JulianKang/ece477/(list of files, cad)

Other CAD files:
Assembly v8.f3d
