JulianKang/ece477/0_assemb_ledboard/blinkyboard/blinkyboard.kicad_pcb

## KiCad design 0_assemb_ledboard/blinkyboard/blinkyboard.kicad_pcb (2024-03-07)

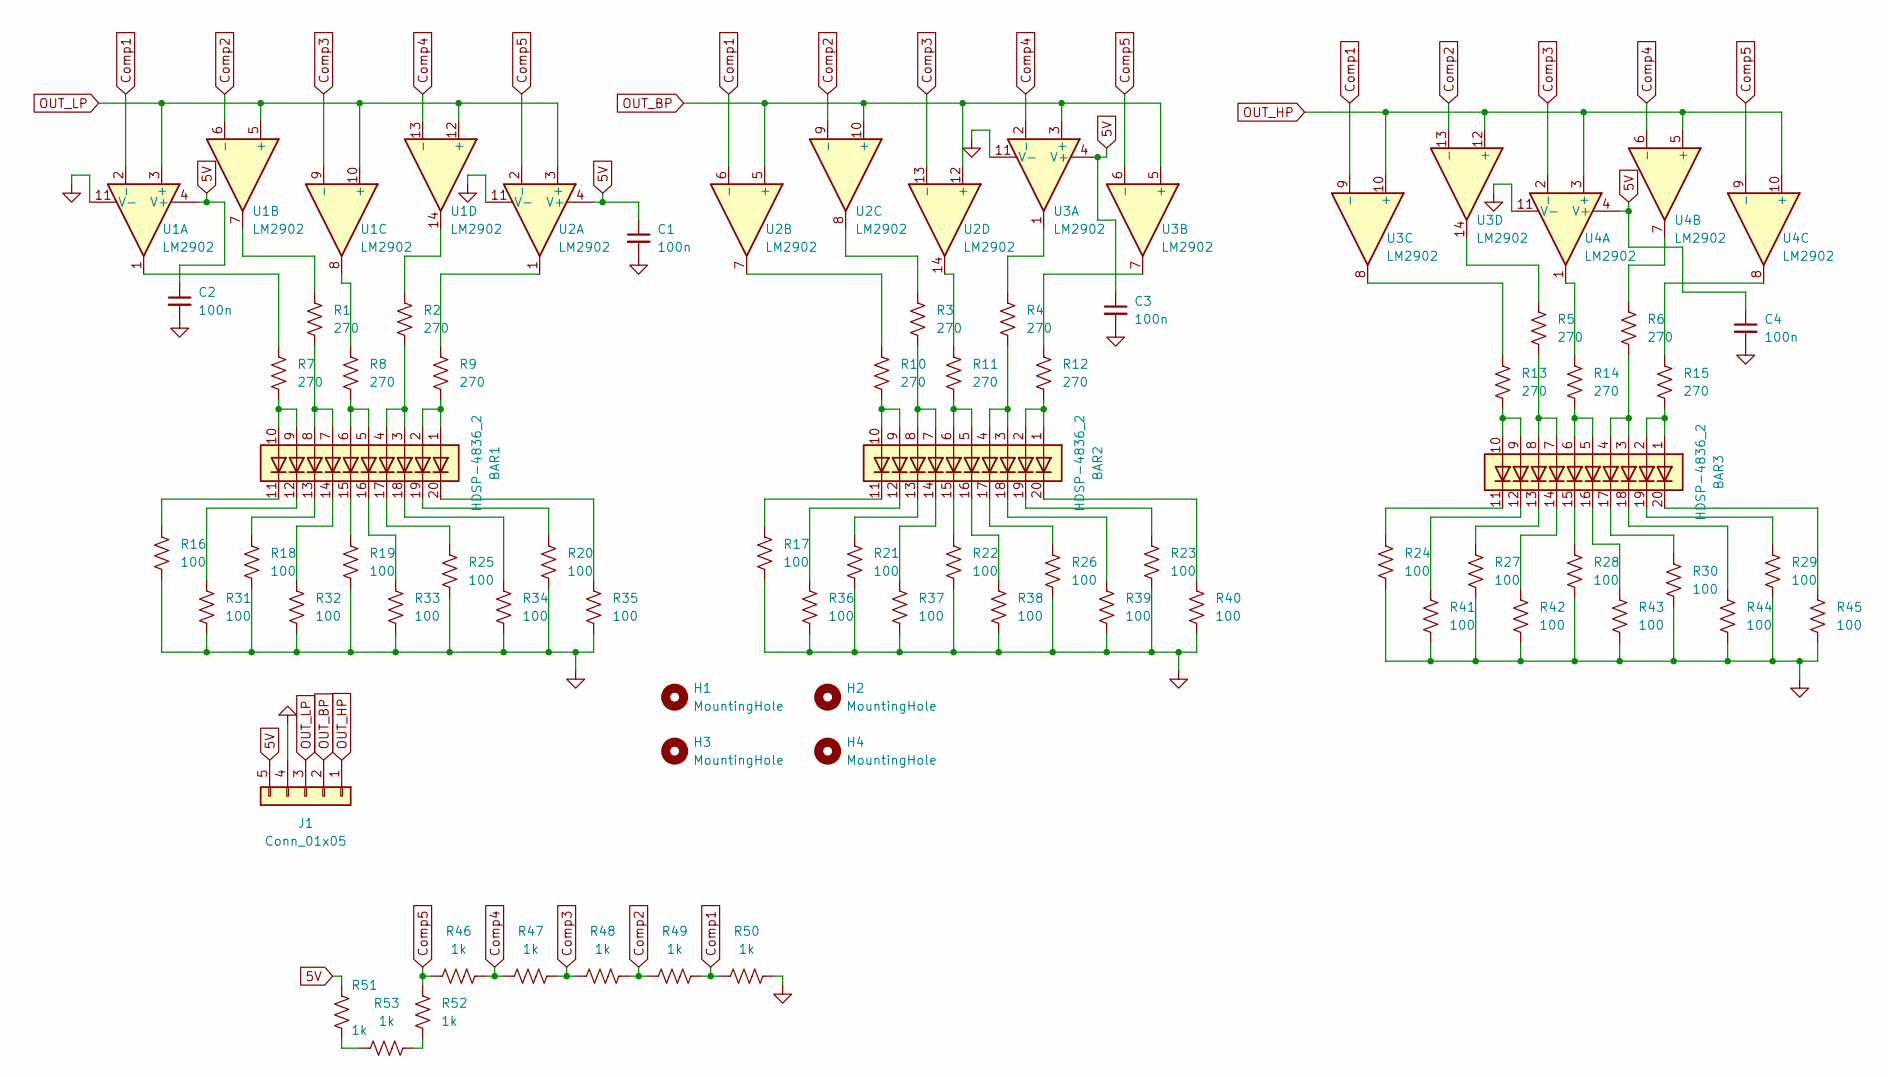
[picture p1: schematic blinkyboard.kicad_sch]

Parts:
BAR1, BAR2, BAR3: HDSP-4836_2; HDSP-4836
C1, C2, C3, C4: 100n; C_0805_2012Metric
H1, H2, H3, H4: MountingHole; MountingHole_3.2mm_M3_DIN965
J1: Conn_01x05; PinHeader_1x05_P2.54mm_Vertical
R1, R2, R3, R4, R5, R6, R7, R8, R9, R10, R11, R12, R13, R14, R15: 270; R_0805_2012Metric_Pad1.20x1.40mm_HandSolder
R16, R17, R18, R19, R20, R21, R22, R23, R24, R25, R26, R27, R28, R29, R30, R31, R32, R33, R34, R35, R36, R37, R38, R39, R40, R41, R42, R43, R44, R45: 100; R_0805_2012Metric_Pad1.20x1.40mm_HandSolder
R46, R47, R48, R49, R50, R51, R52, R53: 1k; R_0805_2012Metric_Pad1.20x1.40mm_HandSolder
U1, U2, U3, U4: LM2902; DIP-14_W7.62mm

Connections:
5V: C1.1, C2.1, C3.1, C4.1, J1.5, R51.2, U1.4 (V+), U2.4 (V+), U3.4 (V+), U4.4 (V+)
Comp1: R49.1, R50.2, U1.2 (-), U2.6 (-), U3.9 (-)
Comp2: R48.1, R49.2, U1.6 (-), U2.9 (-), U3.13 (-)
Comp3: R47.1, R48.2, U1.9 (-), U2.13 (-), U4.2 (-)
Comp4: R46.1, R47.2, U1.13 (-), U3.2 (-), U4.6 (-)
Comp5: R46.2, R52.2, U2.2 (-), U3.6 (-), U4.9 (-)
GND: C1.2, C2.2, C3.2, C4.2, J1.4, R16.1, R17.1, R18.1, R19.1, R20.1, R21.1, R22.1, R23.1, R24.1, R25.1, R26.1, R27.1, R28.1, R29.1, R30.1, R31.1, R32.1, R33.1, R34.1, R35.1, R36.1, R37.1, R38.1, R39.1, R40.1, R41.1, R42.1, R43.1, R44.1, R45.1, R50.1, U1.11 (V-), U2.11 (V-), U3.11 (V-), U4.11 (V-)
unnamed: BAR1.1 (A), BAR1.2 (A), R9.1
unnamed: BAR1.3 (A), BAR1.4 (A), R2.1
unnamed: BAR1.5 (A), BAR1.6 (A), R8.1
unnamed: BAR1.7 (A), BAR1.8 (A), R1.1
unnamed: BAR1.9 (A), BAR1.10 (A), R7.1
unnamed: BAR1.11 (K), R16.2
unnamed: BAR1.12 (K), R31.2
unnamed: BAR1.13 (K), R18.2
unnamed: BAR1.14 (K), R32.2
unnamed: BAR1.15 (K), R19.2
unnamed: BAR1.16 (K), R33.2
unnamed: BAR1.17 (K), R25.2
unnamed: BAR1.18 (K), R34.2
unnamed: BAR1.19 (K), R20.2
unnamed: BAR1.20 (K), R35.2
unnamed: BAR2.1 (A), BAR2.2 (A), R12.1
unnamed: BAR2.3 (A), BAR2.4 (A), R4.1
unnamed: BAR2.5 (A), BAR2.6 (A), R11.1
unnamed: BAR2.7 (A), BAR2.8 (A), R3.1
unnamed: BAR2.9 (A), BAR2.10 (A), R10.1
unnamed: BAR2.11 (K), R17.2
unnamed: BAR2.12 (K), R36.2
unnamed: BAR2.13 (K), R21.2
unnamed: BAR2.14 (K), R37.2
unnamed: BAR2.15 (K), R22.2
unnamed: BAR2.16 (K), R38.2
unnamed: BAR2.17 (K), R26.2
unnamed: BAR2.18 (K), R39.2
unnamed: BAR2.19 (K), R23.2
unnamed: BAR2.20 (K), R40.2
unnamed: BAR3.1 (A), BAR3.2 (A), R15.1
unnamed: BAR3.3 (A), BAR3.4 (A), R6.1
unnamed: BAR3.5 (A), BAR3.6 (A), R14.1
unnamed: BAR3.7 (A), BAR3.8 (A), R5.1
unnamed: BAR3.9 (A), BAR3.10 (A), R13.1
unnamed: BAR3.11 (K), R24.2
unnamed: BAR3.12 (K), R41.2
unnamed: BAR3.13 (K), R27.2
unnamed: BAR3.14 (K), R42.2
unnamed: BAR3.15 (K), R28.2
unnamed: BAR3.16 (K), R43.2
unnamed: BAR3.17 (K), R30.2
unnamed: BAR3.18 (K), R44.2
unnamed: BAR3.19 (K), R29.2
unnamed: BAR3.20 (K), R45.2
unnamed: R1.2, U1.7
unnamed: R2.2, U1.14
unnamed: R3.2, U2.8
unnamed: R4.2, U3.1
unnamed: R5.2, U3.14
unnamed: R6.2, U4.7
unnamed: R7.2, U1.1
unnamed: R8.2, U1.8
unnamed: R9.2, U2.1
unnamed: R10.2, U2.7
unnamed: R11.2, U2.14
unnamed: R12.2, U3.7
unnamed: R13.2, U3.8
unnamed: R14.2, U4.1
unnamed: R15.2, U4.8
unnamed: R51.1, R53.2
unnamed: R52.1, R53.1
OUT_BP: J1.2, U2.5 (+), U2.10 (+), U2.12 (+), U3.3 (+), U3.5 (+)
OUT_HP: J1.1, U3.10 (+), U3.12 (+), U4.3 (+), U4.5 (+), U4.10 (+)
OUT_LP: J1.3, U1.3 (+), U1.5 (+), U1.10 (+), U1.12 (+), U2.3 (+)

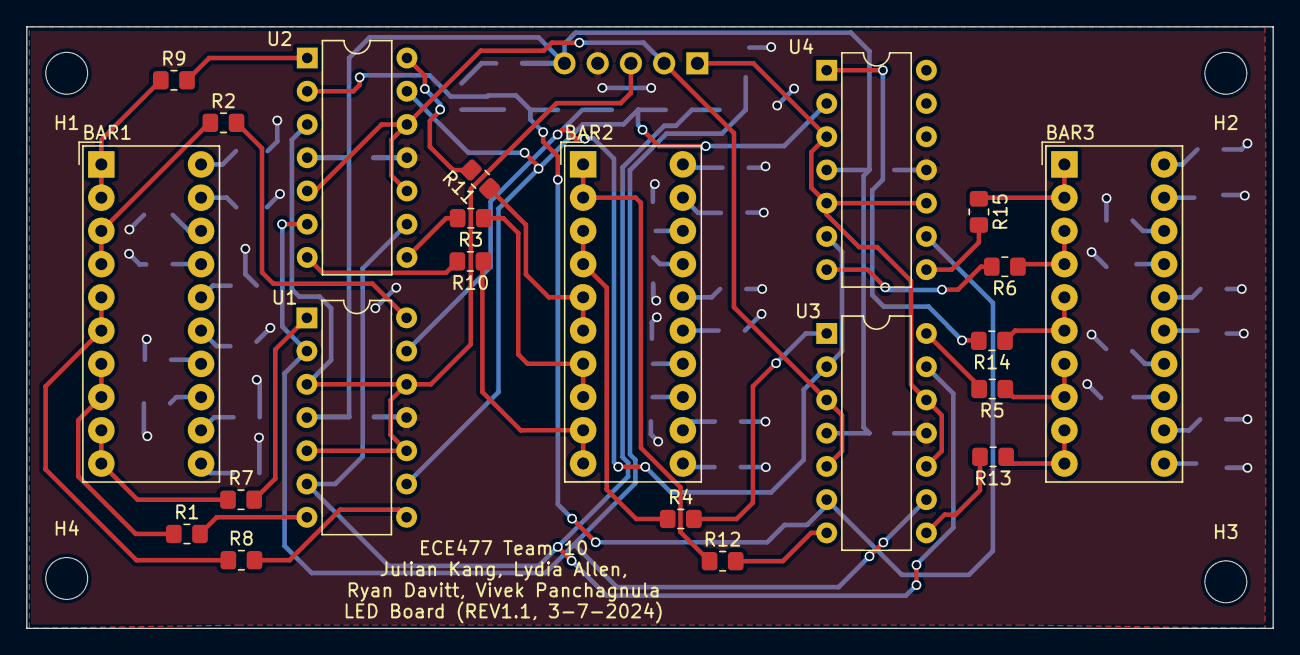
[picture p2: board blinkyboard.kicad_pcb from above]

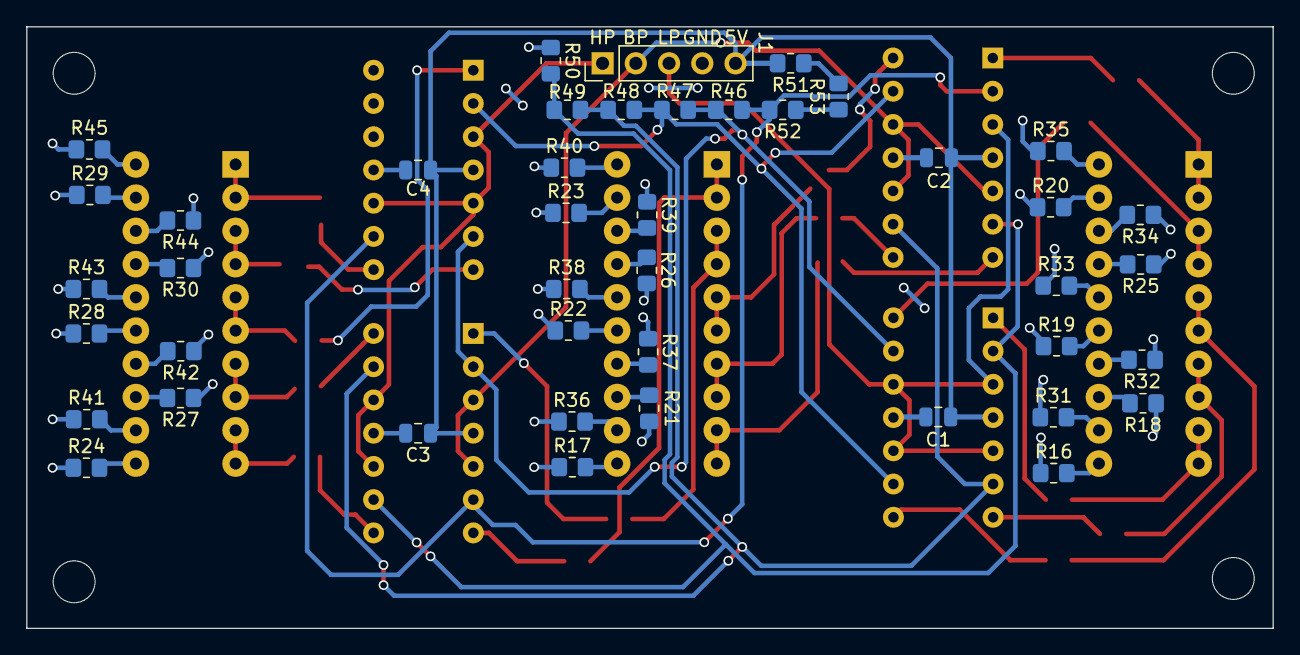
[picture p3: board blinkyboard.kicad_pcb from below]

Board: 2 copper layers, 95.2 x 46.0 mm, 69 parts (43 on the bottom side), 72 nets.
