JulianKang/ece477/0_assemb_full/assemb_full.kicad_pcb

## KiCad design 0_assemb_full/assemb_full.kicad_pcb (2024-03-07)

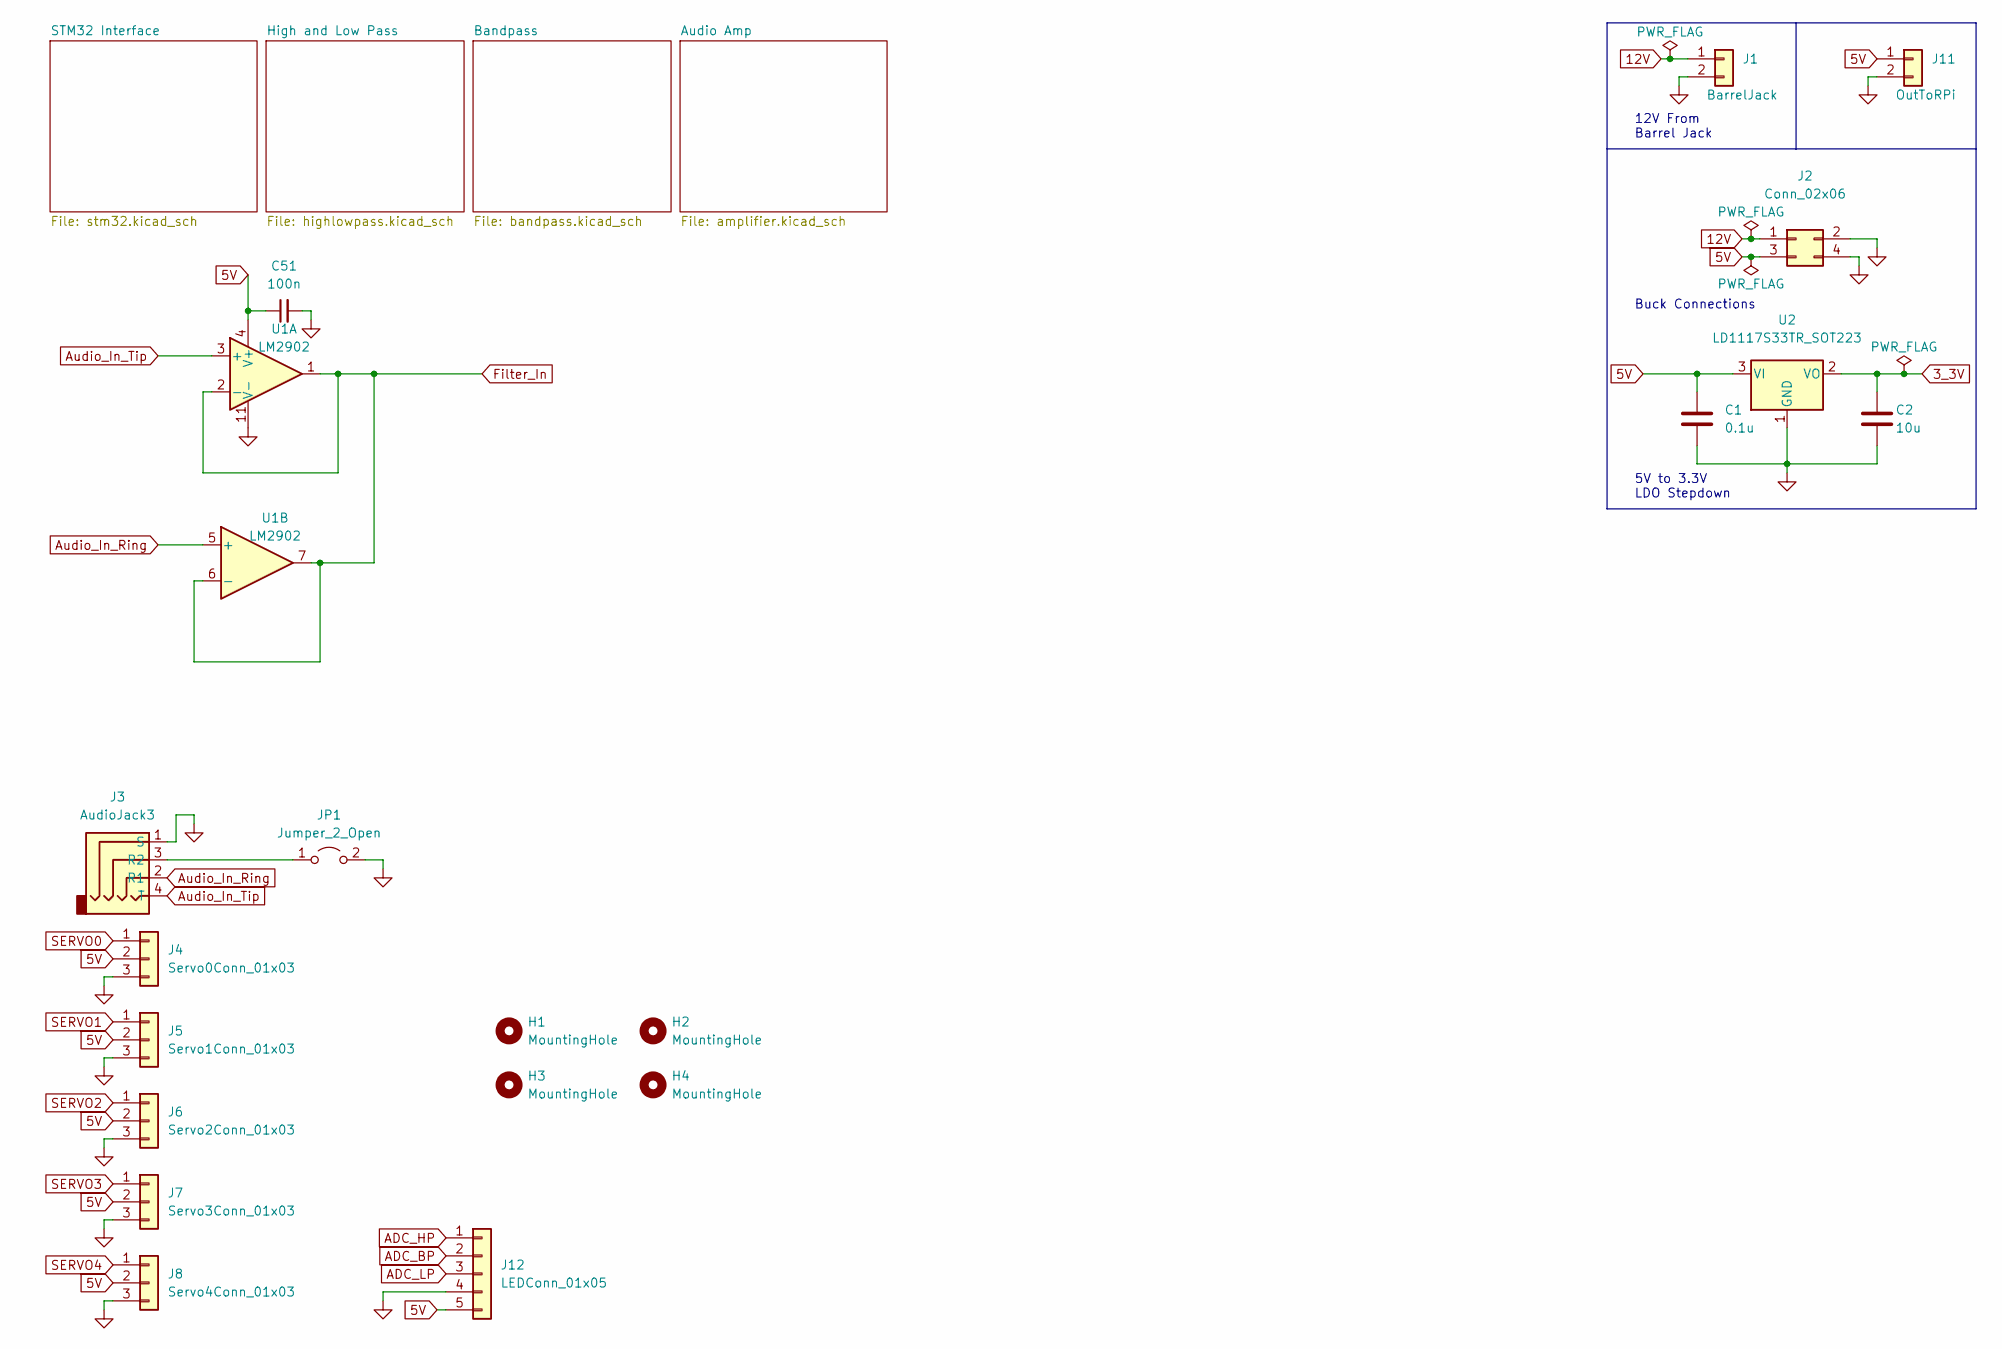
[picture p4: schematic assemb_full.kicad_sch, Power and Board I/O]

Parts:
C1: 0.1u; C_0805_2012Metric_Pad1.18x1.45mm_HandSolder
C2: 10u; C_0805_2012Metric_Pad1.18x1.45mm_HandSolder
C51: 100n; C_0805_2012Metric_Pad1.18x1.45mm_HandSolder
H1, H2, H3, H4: MountingHole; MountingHole_3.2mm_M3
J1: BarrelJack; BarrelJack_GCT_DCJ200-10-A_Horizontal
J2: Conn_02x06; PinHeader_2x02_P2.54mm_Vertical
J3: AudioJack3; PinSocket_1x04_P2.54mm_Vertical
J4: Servo0Conn_01x03; PinHeader_1x03_P2.54mm_Vertical
J5: Servo1Conn_01x03; PinHeader_1x03_P2.54mm_Vertical
J6: Servo2Conn_01x03; PinHeader_1x03_P2.54mm_Vertical
J7: Servo3Conn_01x03; PinHeader_1x03_P2.54mm_Vertical
J8: Servo4Conn_01x03; PinHeader_1x03_P2.54mm_Vertical
J11: OutToRPi; PinHeader_1x02_P2.54mm_Vertical
J12: LEDConn_01x05; PinHeader_1x05_P2.54mm_Vertical
JP1: Jumper_2_Open; SolderJumper-2_P1.3mm_Open_Pad1.0x1.5mm
U1: LM2902; DIP-14_W7.62mm
U2: LD1117S33TR_SOT223; SOT-223-3_TabPin2

Connections:
3_3V: C2.1, U2.2 (VO); also elsewhere on the board
5V: C1.1, C51.1, J2.3, J4.2, J5.2, J6.2, J7.2, J8.2, J11.1, J12.5, U1.4 (V+), U2.3 (VI); also elsewhere on the board
12V: J1.1, J2.1; also elsewhere on the board
ADC_BP: J12.2; also elsewhere on the board
ADC_HP: J12.1; also elsewhere on the board
ADC_LP: J12.3; also elsewhere on the board
Audio_In_Ring: J3.2 (R1), U1.5 (+); also elsewhere on the board
Audio_In_Tip: J3.4 (T), U1.3 (+); also elsewhere on the board
Filter_In: U1.1, U1.2 (-), U1.6 (-), U1.7; also elsewhere on the board
GND: C1.2, C2.2, C51.2, J1.2, J2.2, J2.4, J3.1 (S), J4.3, J5.3, J6.3, J7.3, J8.3, J11.2, J12.4, JP1.2 (B), U1.11 (V-), U2.1 (GND); also elsewhere on the board
unnamed: J3.3 (R2), JP1.1 (A)
SERVO0: J4.1; also elsewhere on the board
SERVO1: J5.1; also elsewhere on the board
SERVO2: J6.1; also elsewhere on the board
SERVO3: J7.1; also elsewhere on the board
SERVO4: J8.1; also elsewhere on the board

Notes on the sheet:
12V From Barrel Jack
5V to 3.3V LDO Stepdown
Buck Connections

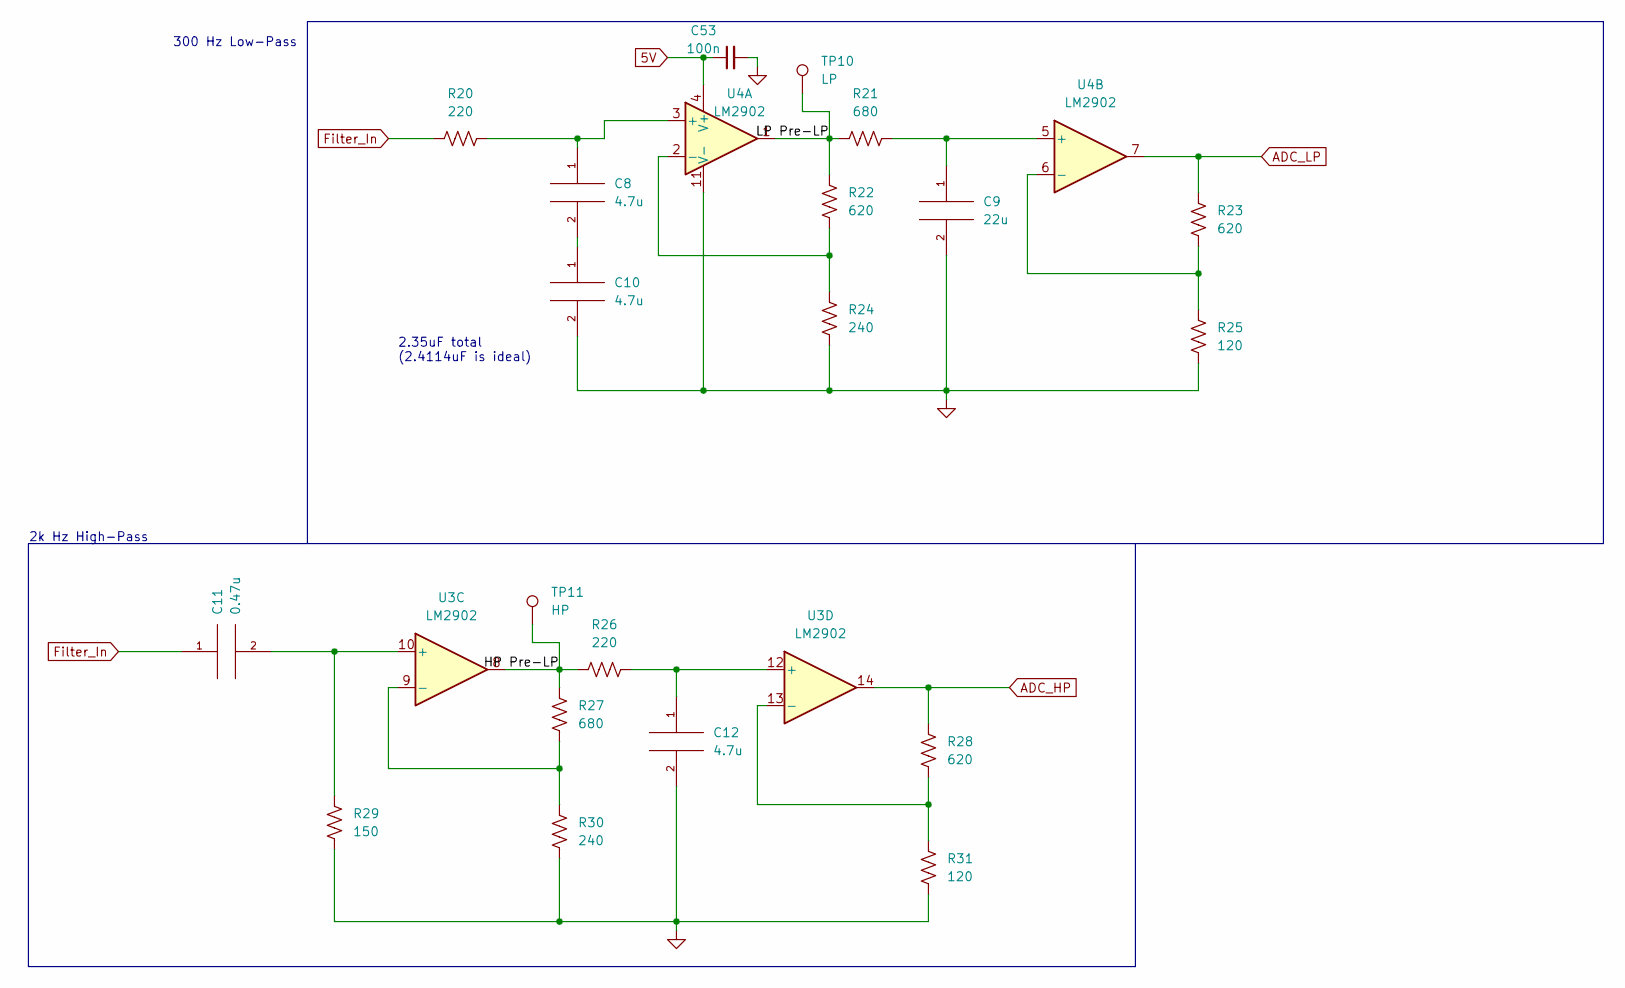
[picture p5: schematic highlowpass.kicad_sch, High and Low Pass Filter]

Parts:
C8, C10, C12: 4.7u; C_Rect_L26.5mm_W7.0mm_P22.50mm_MKS4
C9: 22u; CP_Elec_5x5.8
C11: 0.47u; C_Rect_L7.2mm_W3.5mm_P5.00mm_FKS2_FKP2_MKS2_MKP2
C53: 100n; C_0805_2012Metric_Pad1.18x1.45mm_HandSolder
R20, R26: 220; R_0805_2012Metric_Pad1.20x1.40mm_HandSolder
R21, R27: 680; R_0805_2012Metric_Pad1.20x1.40mm_HandSolder
R22, R23, R28: 620; R_0805_2012Metric_Pad1.20x1.40mm_HandSolder
R24, R30: 240; R_0805_2012Metric_Pad1.20x1.40mm_HandSolder
R25, R31: 120; R_0805_2012Metric_Pad1.20x1.40mm_HandSolder
R29: 150; R_0805_2012Metric_Pad1.20x1.40mm_HandSolder
TP10: LP; TestPoint_THTPad_2.0x2.0mm_Drill1.0mm
TP11: HP; TestPoint_THTPad_2.0x2.0mm_Drill1.0mm
U3, U4: LM2902; DIP-14_W7.62mm

Connections:
5V: C53.1, U4.4 (V+); also elsewhere on the board
/High and Low Pass/HP Pre-LP: R26.1, R27.2, TP11.1, U3.8
/High and Low Pass/LP Pre-LP: R21.1, R22.2, TP10.1, U4.1
ADC_HP: R28.2, U3.14; also elsewhere on the board
ADC_LP: R23.2, U4.7; also elsewhere on the board
Filter_In: C11.1, R20.1; also elsewhere on the board
GND: C9.2, C10.2, C12.2, C53.2, R24.1, R25.1, R29.1, R30.1, R31.1, U4.11 (V-); also elsewhere on the board
unnamed: C8.1, R20.2, U4.3 (+)
unnamed: C9.1, R21.2, U4.5 (+)
unnamed: C8.2, C10.1
unnamed: C11.2, R29.2, U3.10 (+)
unnamed: C12.1, R26.2, U3.12 (+)
unnamed: R22.1, R24.2, U4.2 (-)
unnamed: R23.1, R25.2, U4.6 (-)
unnamed: R27.1, R30.2, U3.9 (-)
unnamed: R28.1, R31.2, U3.13 (-)

Notes on the sheet:
2k Hz High-Pass
2.35uF total (2.4114uF is ideal)
300 Hz Low-Pass

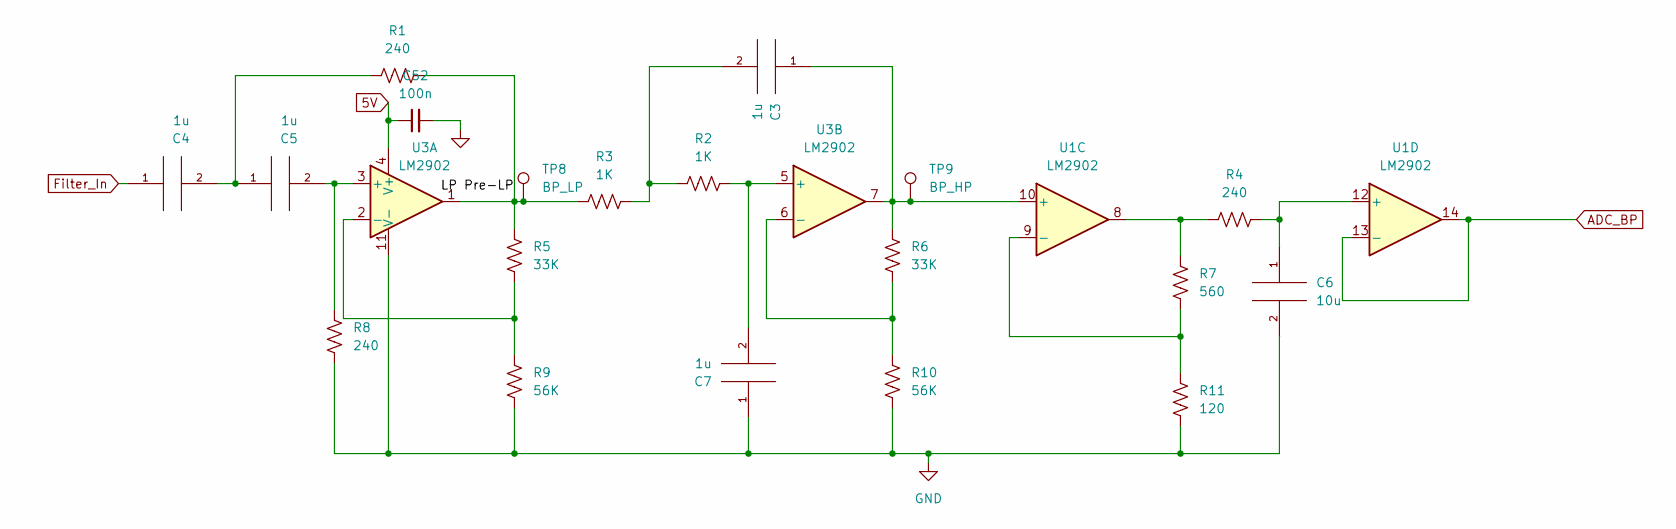
[picture p6: schematic bandpass.kicad_sch, Band Pass Filter]

Parts:
C3, C4, C5, C7: 1u; C_Rect_L7.0mm_W4.5mm_P5.00mm
C6: 10u; CP_Elec_5x5.4
C52: 100n; C_0805_2012Metric_Pad1.18x1.45mm_HandSolder
R1, R4, R8: 240; R_0805_2012Metric_Pad1.20x1.40mm_HandSolder
R2, R3: 1K; R_0805_2012Metric_Pad1.20x1.40mm_HandSolder
R5, R6: 33K; R_0805_2012Metric_Pad1.20x1.40mm_HandSolder
R7: 560; R_0805_2012Metric_Pad1.20x1.40mm_HandSolder
R9, R10: 56K; R_0805_2012Metric_Pad1.20x1.40mm_HandSolder
R11: 120; R_0805_2012Metric_Pad1.20x1.40mm_HandSolder
TP8: BP_LP; TestPoint_THTPad_2.0x2.0mm_Drill1.0mm
TP9: BP_HP; TestPoint_THTPad_2.0x2.0mm_Drill1.0mm
U1, U3: LM2902; DIP-14_W7.62mm

Connections:
5V: C52.1, U3.4 (V+); also elsewhere on the board
/Bandpass/LP Pre-LP: R1.1, R3.2, R5.2, TP8.1, U3.1
ADC_BP: U1.13 (-), U1.14; also elsewhere on the board
Filter_In: C4.1; also elsewhere on the board
GND: C6.2, C7.1, C52.2, R8.1, R9.1, R10.1, R11.1, U3.11 (V-); also elsewhere on the board
unnamed: C3.1, R6.2, TP9.1, U1.10 (+), U3.7
unnamed: C3.2, R2.2, R3.1
unnamed: C4.2, C5.1, R1.2
unnamed: C5.2, R8.2, U3.3 (+)
unnamed: C6.1, R4.2, U1.12 (+)
unnamed: C7.2, R2.1, U3.5 (+)
unnamed: R4.1, R7.2, U1.8
unnamed: R5.1, R9.2, U3.2 (-)
unnamed: R6.1, R10.2, U3.6 (-)
unnamed: R7.1, R11.2, U1.9 (-)

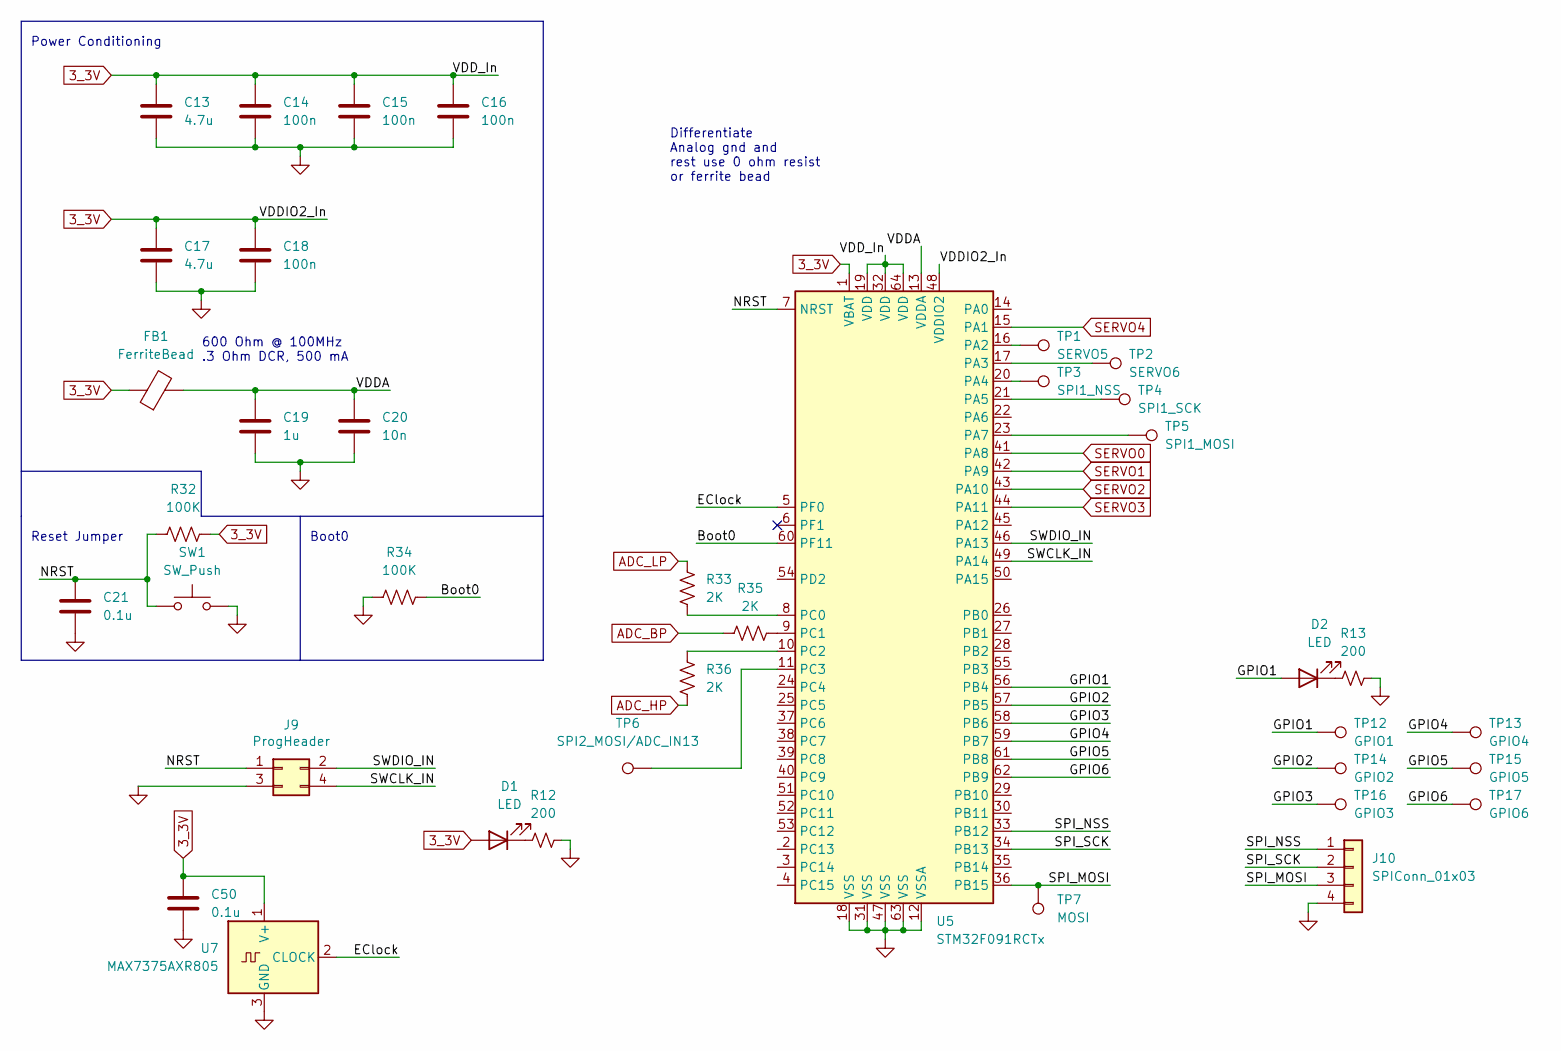
[picture p7: schematic stm32.kicad_sch, STM32 Interfacing]

Parts:
C13, C17: 4.7u; C_0805_2012Metric_Pad1.18x1.45mm_HandSolder
C14, C15, C16, C18: 100n; C_0805_2012Metric_Pad1.18x1.45mm_HandSolder
C19: 1u; C_0805_2012Metric_Pad1.18x1.45mm_HandSolder
C20: 10n; C_0805_2012Metric_Pad1.18x1.45mm_HandSolder
C21, C50: 0.1u; C_0805_2012Metric_Pad1.18x1.45mm_HandSolder
D1, D2: LED; LED_0805_2012Metric_Pad1.15x1.40mm_HandSolder
FB1: FerriteBead; R_0805_2012Metric_Pad1.20x1.40mm_HandSolder
J9: ProgHeader; PinHeader_2x02_P2.54mm_Vertical
J10: SPIConn_01x03; PinHeader_1x04_P2.54mm_Vertical
R12, R13: 200; R_0805_2012Metric_Pad1.20x1.40mm_HandSolder
R32, R34: 100K; R_0805_2012Metric_Pad1.20x1.40mm_HandSolder
R33, R35, R36: 2K; R_0805_2012Metric_Pad1.20x1.40mm_HandSolder
SW1: SW_Push; SW_PUSH-12mm_Wuerth-430476085716
TP1: SERVO5; TestPoint_THTPad_1.5x1.5mm_Drill0.7mm
TP2: SERVO6; TestPoint_THTPad_1.5x1.5mm_Drill0.7mm
TP3: SPI1_NSS; TestPoint_THTPad_1.5x1.5mm_Drill0.7mm
TP4: SPI1_SCK; TestPoint_THTPad_1.5x1.5mm_Drill0.7mm
TP5: SPI1_MOSI; TestPoint_THTPad_1.5x1.5mm_Drill0.7mm
TP6: SPI2_MOSI/ADC_IN13; TestPoint_THTPad_1.5x1.5mm_Drill0.7mm
TP7: MOSI; TestPoint_THTPad_2.0x2.0mm_Drill1.0mm
TP12: GPIO1; TestPoint_THTPad_2.0x2.0mm_Drill1.0mm
TP13: GPIO4; TestPoint_THTPad_2.0x2.0mm_Drill1.0mm
TP14: GPIO2; TestPoint_THTPad_2.0x2.0mm_Drill1.0mm
TP15: GPIO5; TestPoint_THTPad_2.0x2.0mm_Drill1.0mm
TP16: GPIO3; TestPoint_THTPad_2.0x2.0mm_Drill1.0mm
TP17: GPIO6; TestPoint_THTPad_2.0x2.0mm_Drill1.0mm
U5: STM32F091RCTx; LQFP-64_10x10mm_P0.5mm
U7: MAX7375AXR805; SOT-323_SC-70

Connections:
3_3V: C13.1, C14.1, C15.1, C16.1, C17.1, C18.1, C50.1, D1.2 (A), FB1.1, R32.2, U5.1 (VBAT), U5.19 (VDD), U5.32 (VDD), U5.48 (VDDIO2), U5.64 (VDD), U7.1 (V+); also elsewhere on the board
/STM32 Interface/Boot0: R34.2, U5.60 (PF11)
/STM32 Interface/EClock: U5.5 (PF0), U7.2 (CLOCK)
/STM32 Interface/GPIO1: D2.2 (A), TP12.1, U5.56 (PB4)
/STM32 Interface/GPIO2: TP14.1, U5.57 (PB5)
/STM32 Interface/GPIO3: TP16.1, U5.58 (PB6)
/STM32 Interface/GPIO4: TP13.1, U5.59 (PB7)
/STM32 Interface/GPIO5: TP15.1, U5.61 (PB8)
/STM32 Interface/GPIO6: TP17.1, U5.62 (PB9)
/STM32 Interface/NRST: C21.1, J9.1, R32.1, SW1.1, U5.7 (NRST)
/STM32 Interface/SPI_MOSI: J10.3, TP7.1, U5.36 (PB15)
/STM32 Interface/SPI_NSS: J10.1, U5.33 (PB12)
/STM32 Interface/SPI_SCK: J10.2, U5.34 (PB13)
/STM32 Interface/SWCLK_IN: J9.4, U5.49 (PA14)
/STM32 Interface/SWDIO_IN: J9.2, U5.46 (PA13)
/STM32 Interface/VDDA: C19.1, C20.1, FB1.2, U5.13 (VDDA)
ADC_BP: R35.1; also elsewhere on the board
ADC_HP: R36.1; also elsewhere on the board
ADC_LP: R33.2; also elsewhere on the board
GND: C13.2, C14.2, C15.2, C16.2, C17.2, C18.2, C19.2, C20.2, C21.2, C50.2, J9.3, J10.4, R12.2, R13.2, R34.1, SW1.2, U5.12 (VSSA), U5.18 (VSS), U5.31 (VSS), U5.47 (VSS), U5.63 (VSS), U7.3 (GND); also elsewhere on the board
unnamed: D1.1 (K), R12.1
unnamed: D2.1 (K), R13.1
unnamed: R33.1, U5.8 (PC0)
unnamed: R35.2, U5.9 (PC1)
unnamed: R36.2, U5.10 (PC2)
unnamed: TP1.1, U5.16 (PA2)
unnamed: TP2.1, U5.17 (PA3)
unnamed: TP3.1, U5.20 (PA4)
unnamed: TP4.1, U5.21 (PA5)
unnamed: TP5.1, U5.23 (PA7)
unnamed: TP6.1, U5.11 (PC3)
SERVO0: U5.41 (PA8); also elsewhere on the board
SERVO1: U5.42 (PA9); also elsewhere on the board
SERVO2: U5.43 (PA10); also elsewhere on the board
SERVO3: U5.44 (PA11); also elsewhere on the board
SERVO4: U5.15 (PA1); also elsewhere on the board

Notes on the sheet:
Differentiate Analog gnd and rest use 0 ohm resist or ferrite bead
600 Ohm @ 100MHz .3 Ohm DCR, 500 mA
Boot0
Power Conditioning
Reset Jumper

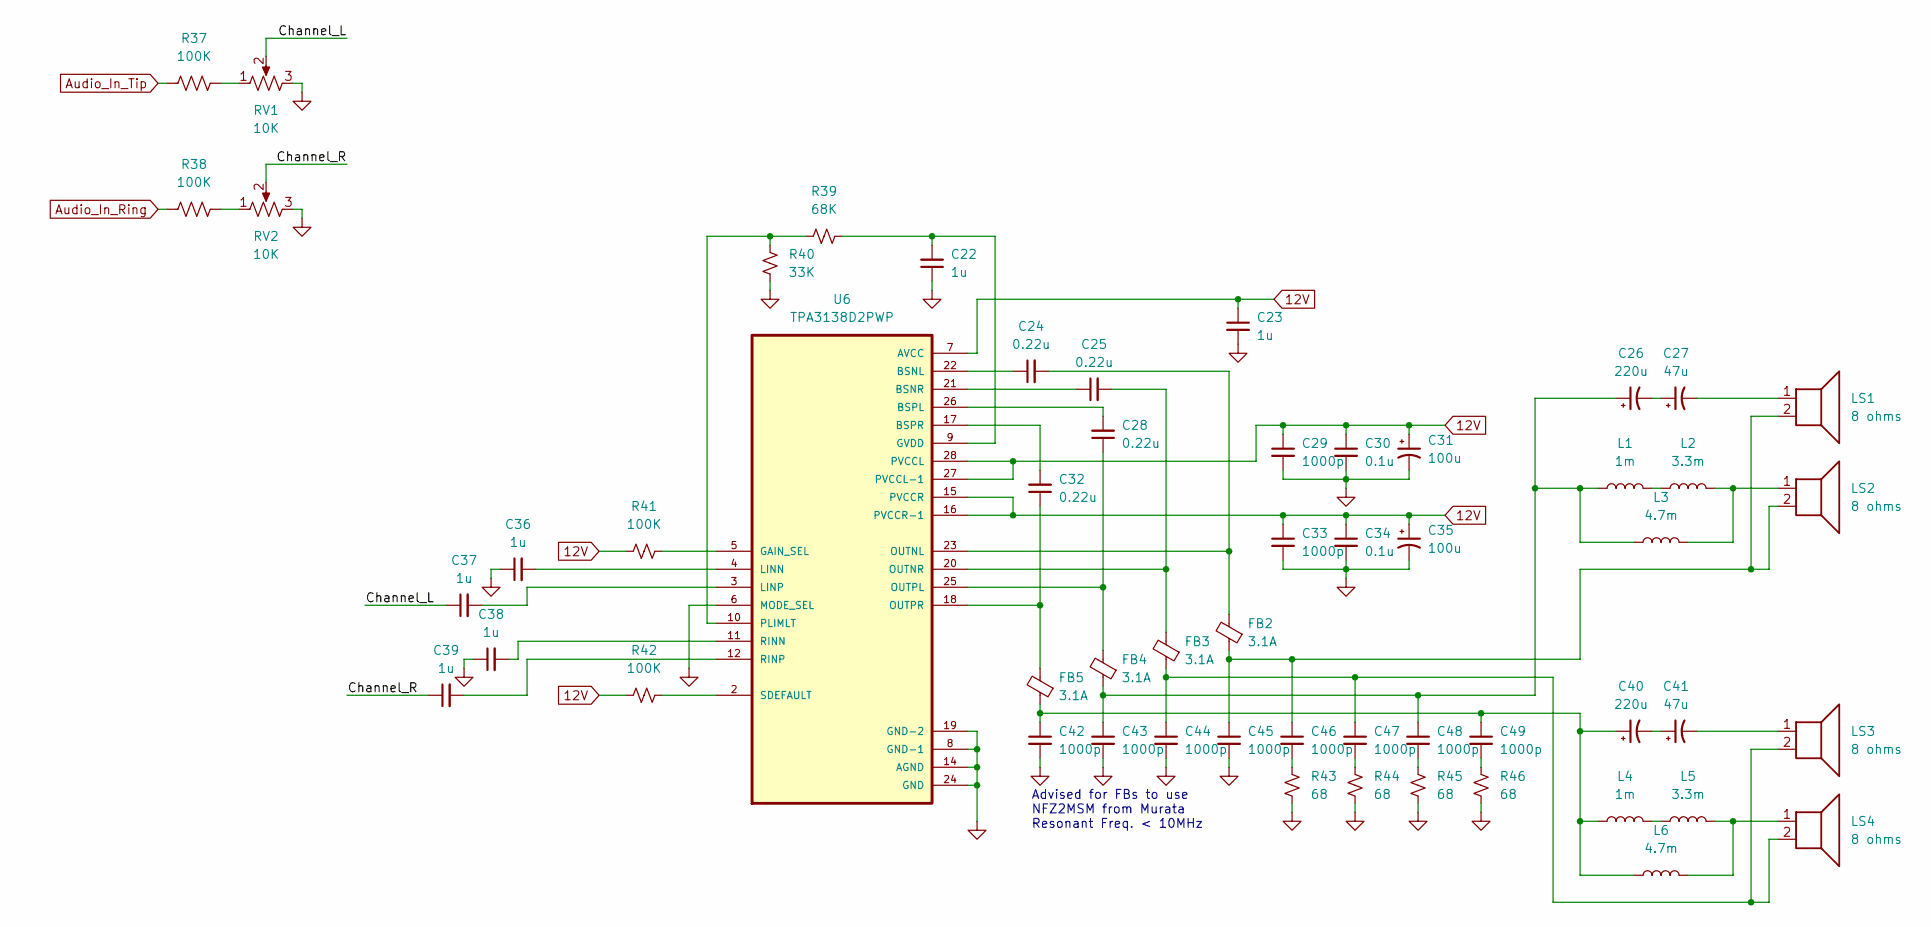
[picture p8: schematic amplifier.kicad_sch, Class-D Amplifier]

Parts:
C22, C23, C36, C37, C38, C39: 1u; C_0805_2012Metric_Pad1.18x1.45mm_HandSolder
C24, C25, C28, C32: 0.22u; C_0805_2012Metric_Pad1.18x1.45mm_HandSolder
C26, C40: 220u; CP_Radial_D6.3mm_P2.50mm
C27, C41: 47u; CP_Radial_D6.3mm_P2.50mm
C29, C33, C42, C43, C44, C45, C46, C47, C48, C49: 1000p; C_0805_2012Metric_Pad1.18x1.45mm_HandSolder
C30, C34: 0.1u; C_0805_2012Metric_Pad1.18x1.45mm_HandSolder
C31, C35: 100u; CP_Radial_D5.0mm_P2.50mm
FB2, FB3, FB4, FB5: 3.1A; BEADC2016X100N
L1, L4: 1m; L_Radial_D9.5mm_P5.00mm_Fastron_07HVP
L2, L5: 3.3m; L_Radial_D9.5mm_P5.00mm_Fastron_07HVP
L3, L6: 4.7m; L_Radial_D9.5mm_P5.00mm_Fastron_07HVP
LS1, LS2, LS3, LS4: 8 ohms; SolderWire-2sqmm_1x02_P7.8mm_D2mm_OD3.9mm
R37, R38, R41, R42: 100K; R_0805_2012Metric_Pad1.20x1.40mm_HandSolder
R39: 68K; R_0805_2012Metric_Pad1.20x1.40mm_HandSolder
R40: 33K; R_0805_2012Metric_Pad1.20x1.40mm_HandSolder
R43, R44, R45, R46: 68; R_0805_2012Metric_Pad1.20x1.40mm_HandSolder
RV1, RV2: 10K; Potentiometer_Vishay_148-149_Single_Vertical
U6: TPA3138D2PWP; IC_TPS61196PWPRQ1

Connections:
12V: C23.1, C29.1, C30.1, C31.1, C33.1, C34.1, C35.1, R41.1, R42.1, U6.7 (AVCC), U6.15 (PVCCR), U6.16 (PVCCR-1), U6.27 (PVCCL-1), U6.28 (PVCCL); also elsewhere on the board
/Audio Amp/Channel_L: C37.1, RV1.2
/Audio Amp/Channel_R: C39.1, RV2.2
Audio_In_Ring: R38.1; also elsewhere on the board
Audio_In_Tip: R37.1; also elsewhere on the board
GND: C22.1, C23.2, C29.2, C30.2, C31.2, C33.2, C34.2, C35.2, C36.1, C38.1, C42.2, C43.2, C44.2, C45.2, R40.1, R43.1, R44.1, R45.1, R46.1, RV1.3, RV2.3, U6.6 (MODE_SEL), U6.8 (GND-1), U6.14 (AGND), U6.19 (GND-2), U6.24 (GND); also elsewhere on the board
unnamed: C22.2, R39.2, U6.9 (GVDD)
unnamed: C24.1, U6.22 (BSNL)
unnamed: C24.2, FB2.2, U6.23 (OUTNL)
unnamed: C25.1, U6.21 (BSNR)
unnamed: C25.2, FB3.2, U6.20 (OUTNR)
unnamed: C26.1, C43.1, C48.1, FB4.1, L1.1, L3.1
unnamed: C26.2, C27.1
unnamed: C27.2, LS1.1
unnamed: C28.1, FB4.2, U6.25 (OUTPL)
unnamed: C28.2, U6.26 (BSPL)
unnamed: C32.1, FB5.2, U6.18 (OUTPR)
unnamed: C32.2, U6.17 (BSPR)
unnamed: C36.2, U6.4 (LINN)
unnamed: C37.2, U6.3 (LINP)
unnamed: C38.2, U6.11 (RINN)
unnamed: C39.2, U6.12 (RINP)
unnamed: C40.1, C42.1, C49.1, FB5.1, L4.1, L6.1
unnamed: C40.2, C41.1
unnamed: C41.2, LS3.1
unnamed: C44.1, C47.1, FB3.1, LS3.2, LS4.2
unnamed: C45.1, C46.1, FB2.1, LS1.2, LS2.2
unnamed: C46.2, R43.2
unnamed: C47.2, R44.2
unnamed: C48.2, R45.2
unnamed: C49.2, R46.2
unnamed: L1.2, L2.1
unnamed: L2.2, L3.2, LS2.1
unnamed: L4.2, L5.1
unnamed: L5.2, L6.2, LS4.1
unnamed: R37.2, RV1.1
unnamed: R38.2, RV2.1
unnamed: R39.1, R40.2, U6.10 (PLIMLT)
unnamed: R41.2, U6.5 (GAIN_SEL)
unnamed: R42.2, U6.2 (SDEFAULT)

Notes on the sheet:
Advised for FBs to use NFZ2MSM from Murata Resonant Freq. < 10MHz
