JulianKang/ece477/0_assemb_full/assemb_full.kicad_pcb

## KiCad design 0_assemb_full/assemb_full.kicad_pcb (continued)

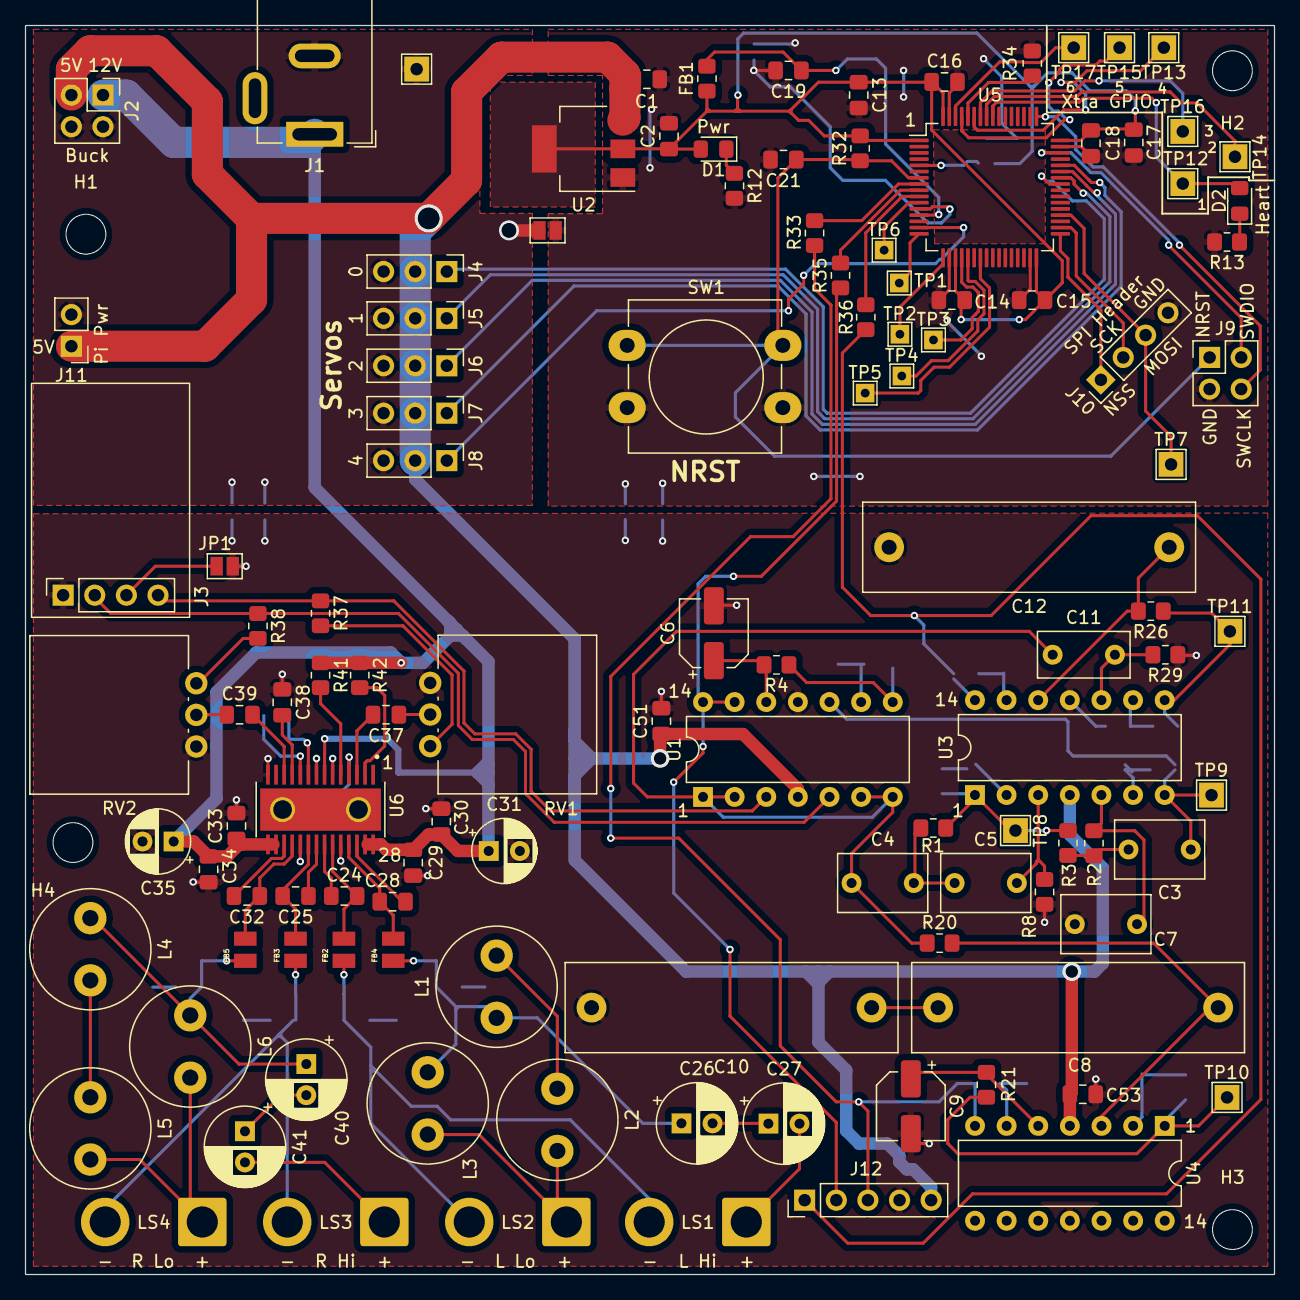
[picture p9: board assemb_full.kicad_pcb from above]

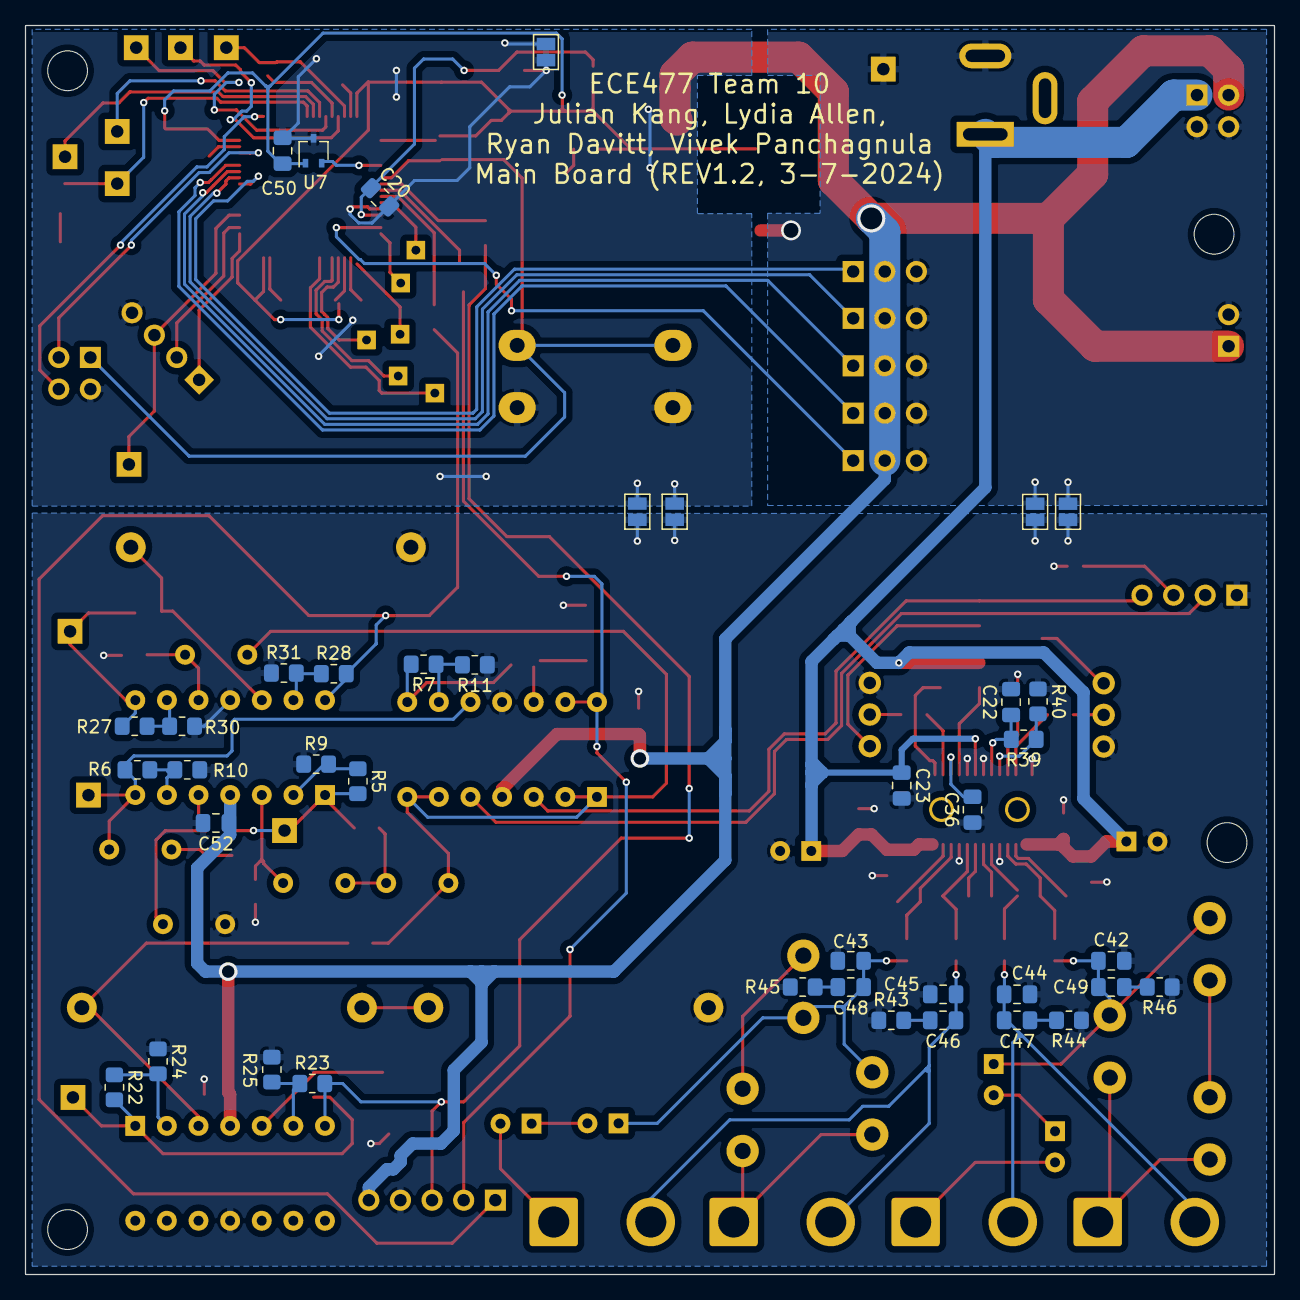
[picture p10: board assemb_full.kicad_pcb from below]

Board: 2 copper layers, 100.3 x 100.3 mm, 154 parts (35 on the bottom side), 100 nets.
