JulianKang/ece477/(commit log)

2024-01-17 Initial KiCAD Uploads
    [1_subassemb_filter.kicad_pcb, 1_subassemb_filter.kicad_sch]
2024-01-18 Updates to the filter
    [1_subassemb_filter.kicad_sch]
2024-01-19 An actually working LP Filter with a hopefully working comparator system for the LEDs.
    [1_subassemb_filter.kicad_sch]
2024-01-20 Fully functional LP Filter and Comparator-Resistor net with the LEDs
    [1_subassemb_filter.kicad_sch]
2024-01-24 Added high-pass filter and made the whole system a bit more modular
    [1_subassemb_filter.kicad_sch]
2024-01-25 Low and high filter systems now ready
    [1_subassemb_filter.kicad_sch]
2024-01-26 Updated with values from the breadboard
    [1_subassemb_filter.kicad_sch]
2024-01-27 Now including band-pass, all circuits prototyped and proven to work
    [1_subassemb_filter.kicad_sch, bandpass.kicad_sch, highlowpass.kicad_sch]
2024-02-06 Added the full schematic file and included the filters
    [1_subassemb_filter.kicad_sch, assemb_full.kicad_pcb, assemb_full.kicad_sch, bandpass.kicad_sch, highlowpass.kicad_sch]
2024-02-06 Added STM32F091RCTx symbol and power symbols
    [assemb_full.kicad_sch, bandpass.kicad_sch, highlowpass.kicad_sch, stm32.kicad_sch]
2024-02-07 Additional changes
    [assemb_full.kicad_sch, bandpass.kicad_sch, highlowpass.kicad_sch, stm32.kicad_sch]
2024-02-07 robot code commit
    [Dancing_Robot_debug.cfg]
2024-02-07 assembly file initial commit
    [Assembly v8.f3d]
2024-02-11 Removed varistors, updated some STM32 connections
    [assemb_full.kicad_sch, bandpass.kicad_sch, highlowpass.kicad_sch, stm32.kicad_sch]
2024-02-13 Bandpass filter all set now!
    [assemb_full.kicad_sch, bandpass.kicad_sch, highlowpass.kicad_sch, stm32.kicad_sch]
2024-02-14 A bunch of changes to the schematics
    [assemb_full.kicad_sch, bandpass.kicad_sch, blinkyboard.kicad_pcb, blinkyboard.kicad_sch, highlowpass.kicad_sch, stm32.kicad_sch]
2024-02-15 Updates to the filter system
    [amplifier.kicad_sch, assemb_full.kicad_sch, bandpass.kicad_sch, highlowpass.kicad_sch, stm32.kicad_sch]
2024-02-16 updated main with adc and changed servo functions
2024-02-17 Added amplifier circuit and the programming header.
    [amplifier.kicad_sch, assemb_full.kicad_sch, bandpass.kicad_sch, highlowpass.kicad_sch, stm32.kicad_sch]
2024-02-21 A lot of work done on the STM32 PCB layout.
    [amplifier.kicad_sch, assemb_full.kicad_pcb, assemb_full.kicad_sch, bandpass.kicad_sch, highlowpass.kicad_sch, stm32.kicad_sch]
2024-02-22 Pre-STM32 portion rework
    [amplifier.kicad_sch, assemb_full.kicad_pcb, assemb_full.kicad_sch, stm32.kicad_sch]
2024-02-23 Some filter adjustments
    [assemb_full.kicad_pcb, assemb_full.kicad_sch, bandpass.kicad_sch, highlowpass.kicad_sch, stm32.kicad_sch]
2024-02-25 Active Filters layout added
    [amplifier.kicad_sch, assemb_full.kicad_pcb, assemb_full.kicad_sch, bandpass.kicad_sch, highlowpass.kicad_sch, stm32.kicad_sch]
2024-02-25 Full PCB layout complete
    [assemb_full.kicad_pcb]
2024-02-26 Final adjustments
    [assemb_full.kicad_pcb, assemb_full.kicad_sch, stm32.kicad_sch]
2024-02-26 Final changes to PCB after footprint tests.
    [assemb_full.kicad_pcb, assemb_full.kicad_sch]
2024-02-27 Final adjustments (mostly silkscreen) pre-presentation
    [assemb_full.kicad_pcb, assemb_full.kicad_sch, stm32.kicad_sch]
2024-03-05 Made adjustments according to presentation feedback. Almost ready for teaching team to look over.
    [assemb_full.kicad_pcb, assemb_full.kicad_sch, bandpass.kicad_sch, highlowpass.kicad_sch, stm32.kicad_sch]
2024-03-07 Fixed LED Board and added GND to SPI on Main Board
    [assemb_full.kicad_pcb, assemb_full.kicad_sch, blinkyboard.kicad_pcb, blinkyboard.kicad_sch, stm32.kicad_sch]
